CloudStas/Sliverflame-TVC_Rocket/BOM.csv

Item | Price | Store | Link | Notes
AITRIP 2PCS ESP32 Dev Boards, 30-Pin, USB-C, ESP-WROOM-32 (CP2102) | $14.99 | Amazon.com | https://www.amazon.com/dp/B0HD9VJG9V | ESP32 #1 = rocket flight computer, ESP32 #2 = breadboard launch controller
ESP32 30-Pin Screw Terminal Breakout Board (board only, no ESP32), 1-Pack | $5.99 | Amazon.com | https://www.amazon.com/dp/B0FT3J8JB2 | For the rocket ESP32 only. Replaces the ESP32-S3 44-pin board, which does not fit
ELEGOO PETG 3D Printer Filament 1.75mm Black 1KG | $12.99 | Amazon.com | https://www.amazon.com/gp/product/B0D41Y3WWZ
TECBEARS PLA Filament 1.75mm, 1kg Black | $9.99 | Amazon.com | https://www.amazon.com/gp/product/B0817W1CLN
8A UBEC Output 5V / 6V 8A Max 12A Input 7V-25.5V 2-6S Lipo / 6-16 Cell NI-Mh Input Switch | $18.98 | Amazon.com | https://www.amazon.com/gp/product/B07DD9L6P6 | Servo power, set to 5 V
SPARKHOBBY ES3352 3352 2.8kg Metal Gear 9mm | $48.28 | Amazon.com | https://www.amazon.com/gp/product/B0DYDD4SK8 | 4 servos: TVC pitch, TVC yaw, throttle left, throttle right
50pcs Stainless Steel Spring Wire - 40CM (15.7") | $9.99 | Amazon.com | https://www.amazon.com/gp/product/B0FK4Z3HTV | Servo pushrods
3pcs GY-521 MPU 6050 | $14.99 | Amazon.com | https://www.amazon.com/gp/product/B0D2TJVMNY
Gebildet 3V-6V-12V-24V-230V/1A 10pcs 7mm Black Prewired Mini Momentary Push Button | $6.99 | Amazon.com | https://www.amazon.com/gp/product/B0CJHXJWN3
HOOVO 2S Shorty Lipo Battery 2200mAh 100C 7.4V Lipo Battery XT60 Plug 2 Pack | $34.43 | Amazon.com | https://www.amazon.com/gp/product/B0CS36X48X
53 PCS Lever Wire Electrical Connectors Nuts Assortment Kit, 28-12 AWG | $8.99 | Amazon.com | https://www.amazon.com/dp/B0F7XNVJSF | Generic lever nuts instead of genuine WAGO 221 ($20.90). Used as BAT+, SERVO +5 V, PYRO+ and GND junctions
DaierTek Mini ON and Off Rocker Switch | $7.99 | Amazon.com | https://www.amazon.com/gp/product/B07S2QJKTX | SW1 main power + SW2 pyro arm
Cable Zip Ties,400 Pack Black Assorted Sizes | $6.99 | Amazon.com | https://www.amazon.com/gp/product/B08TVLYB3Q
40pcs 20 cm (8 inch) Female to Female | $3.99 | Amazon.com | https://www.amazon.com/gp/product/B0BRTJQGS6
15 Pcs 5W 1% Tolerance 1 Ohm Metal Film Resistor | $6.49 | Amazon.com | https://www.amazon.com/gp/product/B0D8J27ZNR | Current limit in series with each igniter
LuminologyPro 1000-Piece Resistor Kit, 25 Values, 1/4W 1% Metal Film | $6.49 | Amazon.com | https://www.amazon.com/dp/B0F4P352BB | Uses 220 ohm (LEDs), 33k + 100k (continuity / battery voltage dividers)
4 Pack 16AWG Waterproof Inline Fuse Holder | $7.99 | Amazon.com | https://www.amazon.com/gp/product/B0F6NPV287 | F1 10 A main, F2 5 A pyro
MOSFET Module MOSFET Switch 4 Channel Drive | $7.39 | Amazon.com | https://www.amazon.com/gp/product/B0GY97176W | Pyro channels: ascent motor, landing motor, leg nichrome
SHILLEHTEK PRE-SOLDERED BMP280 3.3V | $7.49 | Amazon.com | https://www.amazon.com/gp/product/B0CD4PQZGQ
Tenergy Lipo Bag, Fire Retardant Lipo Battery Bag | $8.99 | Amazon.com | https://www.amazon.com/gp/product/B08QCMMGJT
EEEEE M3 Black Nylon Standoff Screws | $9.99 | Amazon.com | https://www.amazon.com/gp/product/B0H323VDZW
FainWan RC Products 3amp - 6.0-25.2v Input / 5v/6v Adjustable Output BEC | $13.99 | Amazon.com | https://www.amazon.com/gp/product/B09L6Z67Q8 | ESP32 logic power, set to 5 V
3 Pairs XT60 Plug Female and Male Connector with 12AWG Silicon Wire | $8.99 | Amazon.com | https://www.amazon.com/gp/product/B07QH249CR
22awg Silicone Electrical Wire Kit Cable 2 Colors 26ft Each Spool | $7.88 | Amazon.com | https://www.amazon.com/gp/product/B08F7BMVJW
Nichrome 80-250' - 32 Gauge Wire - 250ft | $9.49 | Amazon.com | https://www.amazon.com/gp/product/B07CJ63YYT
Super Glue Gel Instant Adhesive, No-Drip, Clear, 12 x 2 g Tubes | $7.99 | Amazon.com | https://www.amazon.com/gp/product/B004YEN37K
PerkHomy Brown Kraft Paper Roll 17.5" x 1,200" (100') | $7.49 | Amazon.com | https://www.amazon.com/gp/product/B0C1RC5Y7F
Litoexpe 5 Pack M3 x 300mm Threaded Rod | $5.49 | Amazon.com | https://www.amazon.com/gp/product/B0D22S97D2
UHT Carbon Fiber Rod 4x500mm Solid Round Bar for RC Craft Modeling Drone | $25.69 | Amazon.com | https://www.amazon.com/gp/product/B0GBVYS5C5
Rubber Bands Size16 500pcs Small Rubber Band For Office Supplies | $6.99 | Amazon.com | https://www.amazon.com/gp/product/B0CNSNG5N9
22pcs 3Pin Servo Extension Cable Cord Male to Female Wire Connectors | $9.99 | Amazon.com | https://www.amazon.com/gp/product/B09BPX1HNS
WG-026 10-Piece Test Lead Set with Alligator Clips, 22 AWG, 20.5-Inch | $5.79 | Amazon.com | https://www.amazon.com/gp/product/B06XX25HFX
Throttle arms laser cut (Steel 1008, 1.5 mm) | $32.66 | SendCutSend.com | CAD/Throttle_Arms.step
Total: | $402.85
Not included: Estes F15 rocket motors (8-pack), 2S/3S LiPo balance charger, USB power bank, breadboard, LEDs, jumper wires
