CloudStas/Sliverflame-TVC_Rocket/CAD/Assembly.step

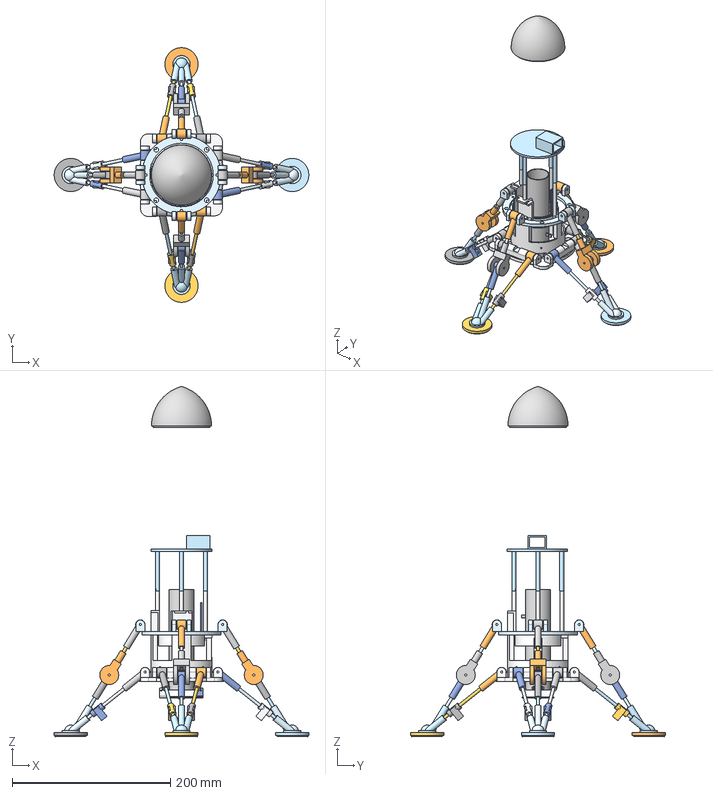
[picture p1: CAD file, 2026-10-26]
CAD/Assembly.step
322.0 x 322.0 x 442.5 mm
Leg2_Band_L
Leg3_Yoke_L
Pin4
Leg4_Rod_A
Throttle_Arm_Left
Leg1_Brace_End
Pin6
Leg3_Knee_Upper
Leg3_Rod_A
YAxis
Leg3_Band_L
Leg1_Band_L
Leg1_Knee_Upper
Leg4_Brace_Up
1_Nose Cone
Leg1_Brace_Lo
Leg1_Rod_A
Pin3
Throttle_Arm_Right
Base_Ring
Leg2_Knee_Lower
Leg4_Knee_Upper
Leg4_Band_L
Leg1_Knee_Lower
Leg3_Brace_End
Leg3_Rod_B
Brace_Ring
Pin2
Leg2_Knee_Upper
Leg3_Yoke_R
Leg3_Band_R
Leg4_Brace_End
Pin1
Leg3_Ankle
Leg3_Brace_Lo
Leg4_Knee_Lower
Leg2_Yoke_R
Leg1_Brace_Up
Leg3_Pad
Leg1_Rod_B
Leg2_Rod_A
Leg2_Rod_B
Leg2_Brace_Lo
TVC_Tube
Leg2_Band_R
Leg3_Brace_Up
Leg4_Pad
Avionics_Base
Leg1_Pad
XAxis
Leg2_Yoke_L
Leg2_Brace_End
Leg1_Ankle
Leg1_Band_R
Leg4_Ankle
Leg4_Rod_B
Leg4_Band_R
Leg2_Brace_Up
Leg4_Brace_Lo
Leg1_Yoke_R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
