CloudStas/Sliverflame-TVC_Rocket/CAD/Landing_Legs.step

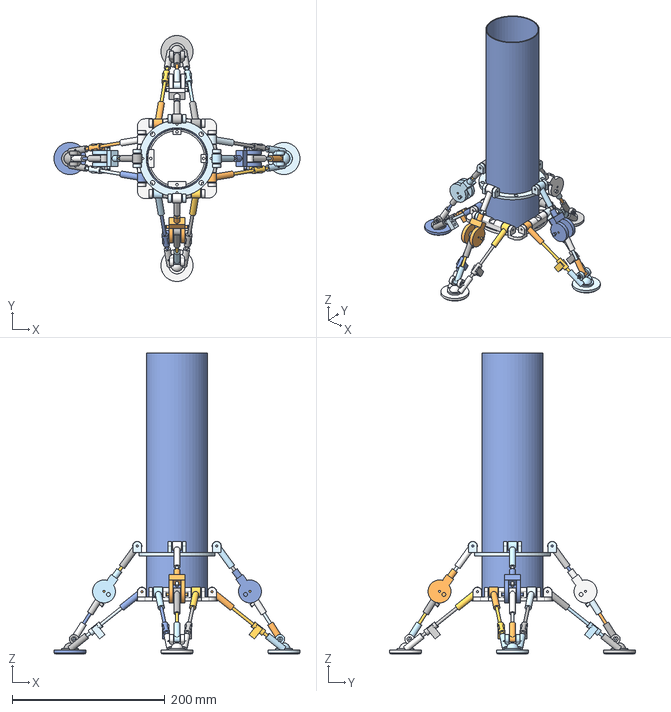
[picture p2: CAD file, 2026-10-26]
CAD/Landing_Legs.step
322.0 x 322.0 x 394.0 mm
