CloudStas/Sliverflame-TVC_Rocket/CAD/Nose_Cone.step

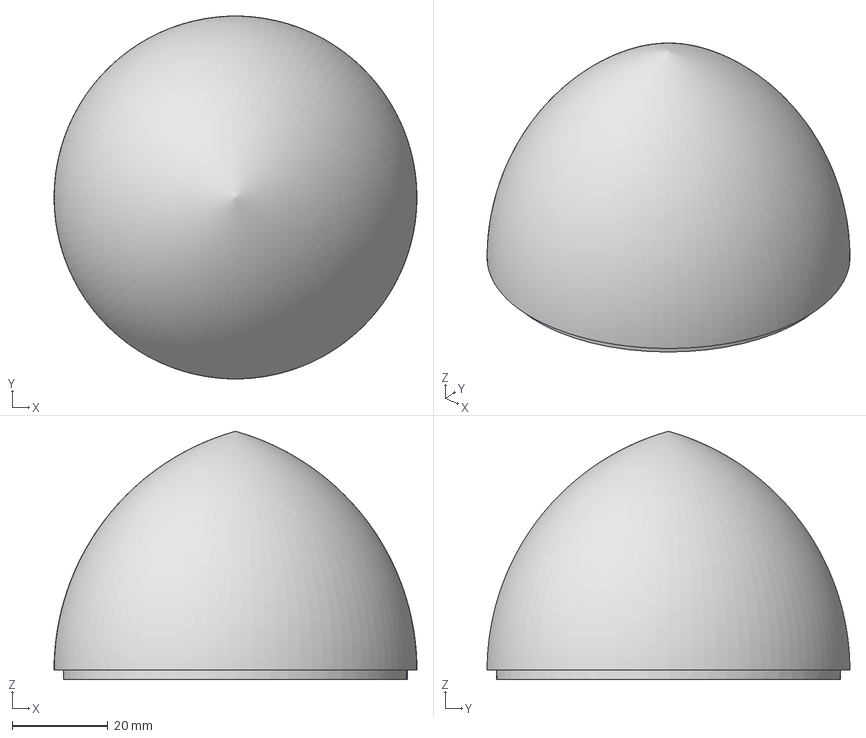
[picture p3: CAD file, 2026-10-26]
CAD/Nose_Cone.step
76.0 x 76.0 x 52.0 mm
