CloudStas/Sliverflame-TVC_Rocket/CAD/Throttle_Arms.step

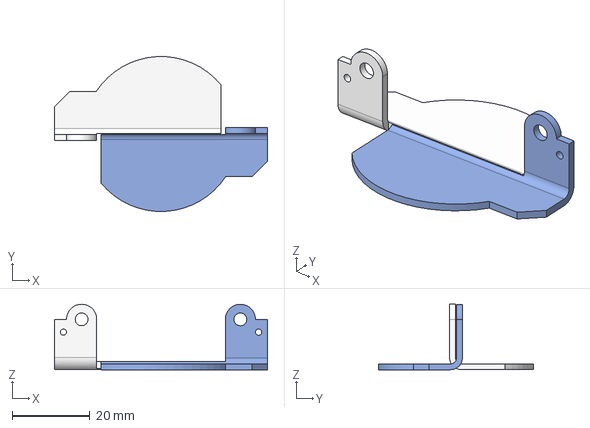
[picture p4: CAD file, 2026-10-26]
CAD/Throttle_Arms.step
55.0 x 39.9 x 16.9 mm
