CloudStas/Sliverflame-TVC_Rocket/CAD/Battery_Mount.step

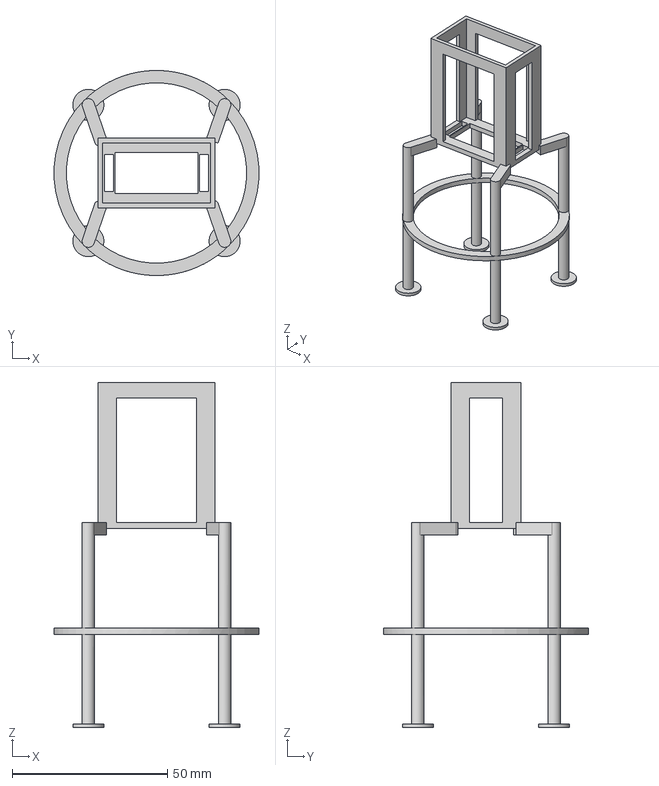
[picture p5: CAD file, 2026-10-26]
CAD/Battery_Mount.step
65.9 x 66.0 x 111.0 mm
