CloudStas/Sliverflame-TVC_Rocket/CAD/TVC_Mount.step

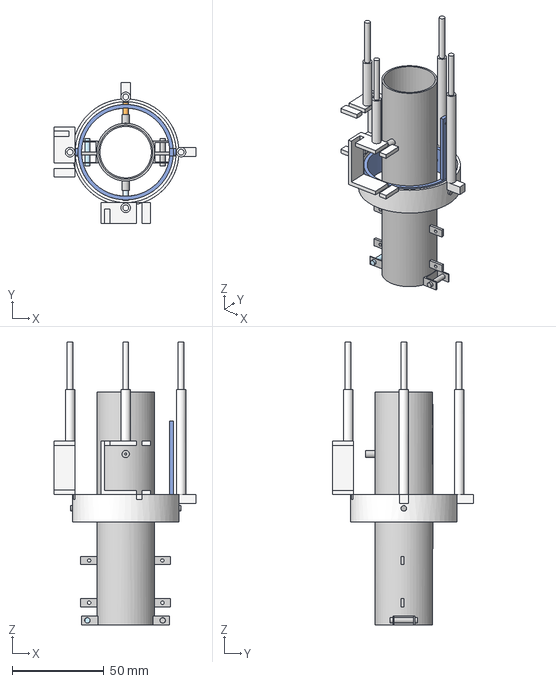
[picture p6: CAD file, 2026-10-26]
CAD/TVC_Mount.step
77.3 x 77.0 x 154.1 mm
