CloudStas/Sliverflame-TVC_Rocket/(commit log)

2026-10-26 Make sure that landing legs can fold and added battery holder model
    [Assembly.step, Avionics_Bay.step, Battery_Mount.step, Landing_Legs.step, Nose_Cone.step, TVC_Mount.step, Throttle_Arms.step]
2026-11-11 Revise progress and BOM total cost in README
    Updated progress details and corrected total cost in the BOM section.
2026-11-11 Revise README with detailed project updates
    Updated the README to clarify the BOM list, wiring details, and safety measures. Added explanations for throttle control and flight computer logic.
2026-11-11 Modify BOM.csv with new items and cost adjustments
    Updated BOM.csv to include new items and notes, and adjusted total cost.
    [BOM.csv]
2026-11-12 Adjust BOM prices and total cost
    Updated prices for avionics, electronics, and hardware components in the BOM.
2026-11-12 Update BOM.csv with new items and price adjustments
    Updated BOM.csv to reflect new item prices and added new items. Adjusted total cost and modified notes for clarity.
    [BOM.csv]
2026-11-12 Revise README with updates on wiring and safety
    Updated wiring and safety information, clarified throttle mechanism, and improved continuity check details.
